Technariumas/dmx-dimmer/sch/dimmer/dimmer.sch.png

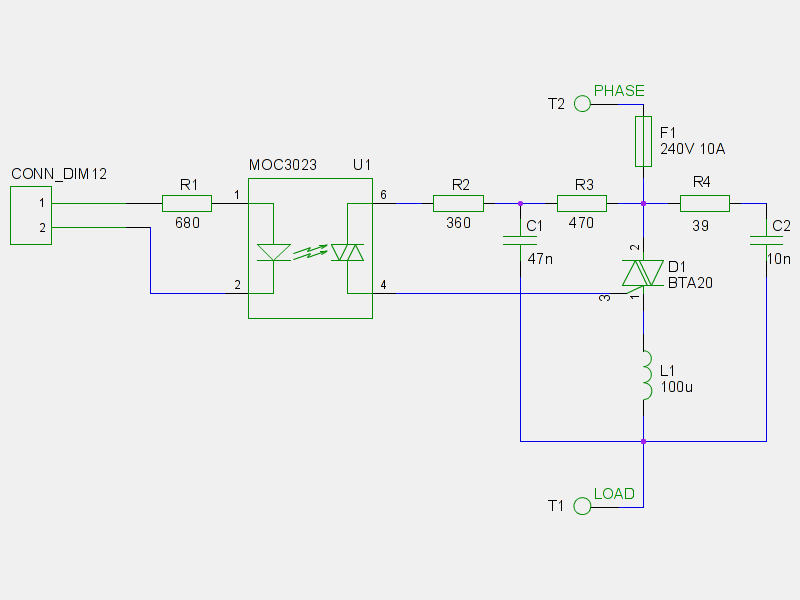
sch/dimmer/dimmer.sch.png
