Technariumas/dmx-dimmer/sch/master/master.sch.png

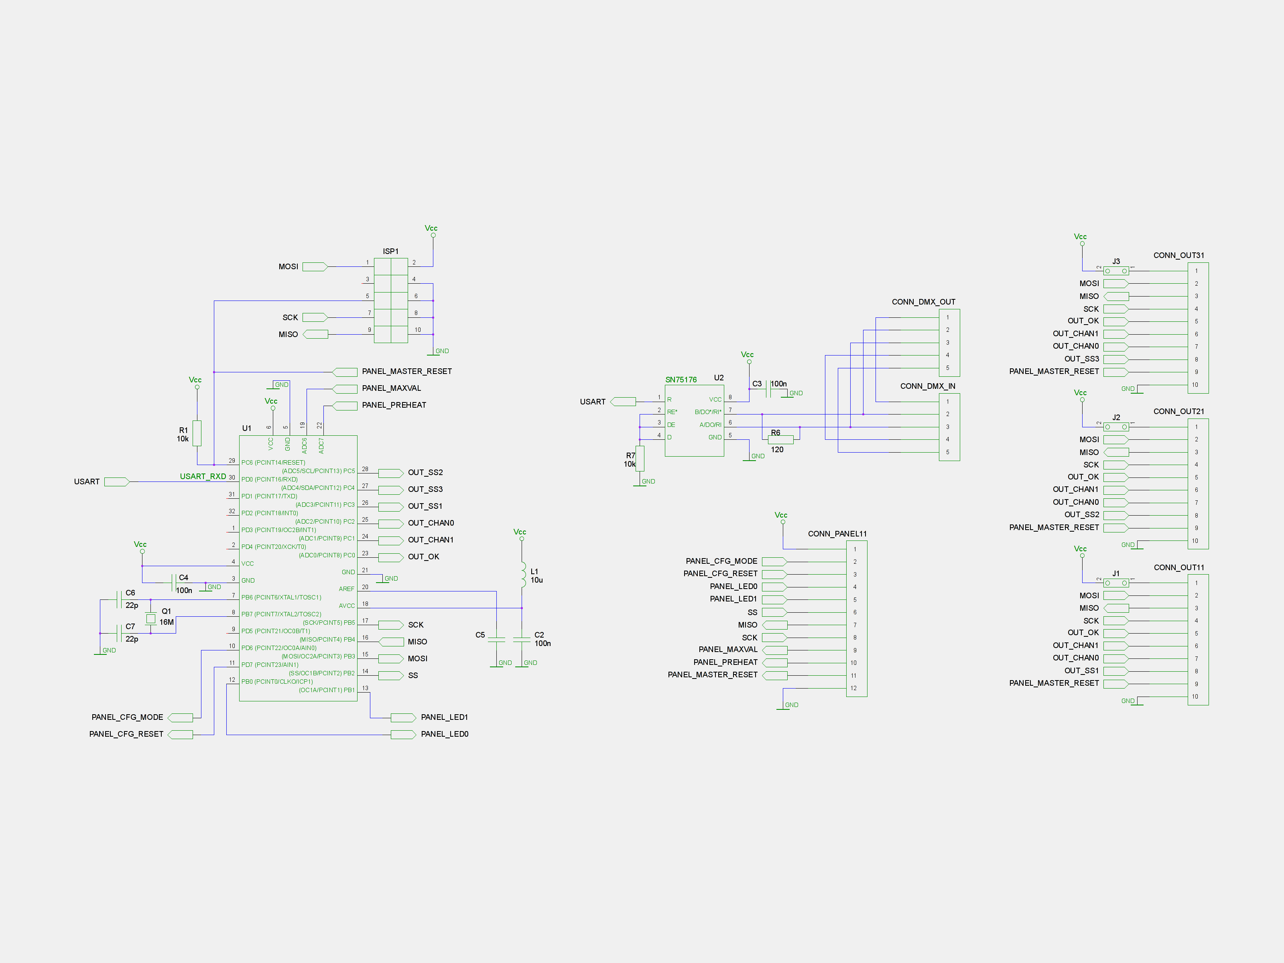
sch/master/master.sch.png
