Technariumas/dmx-dimmer/sch/panel/panel.sch.png

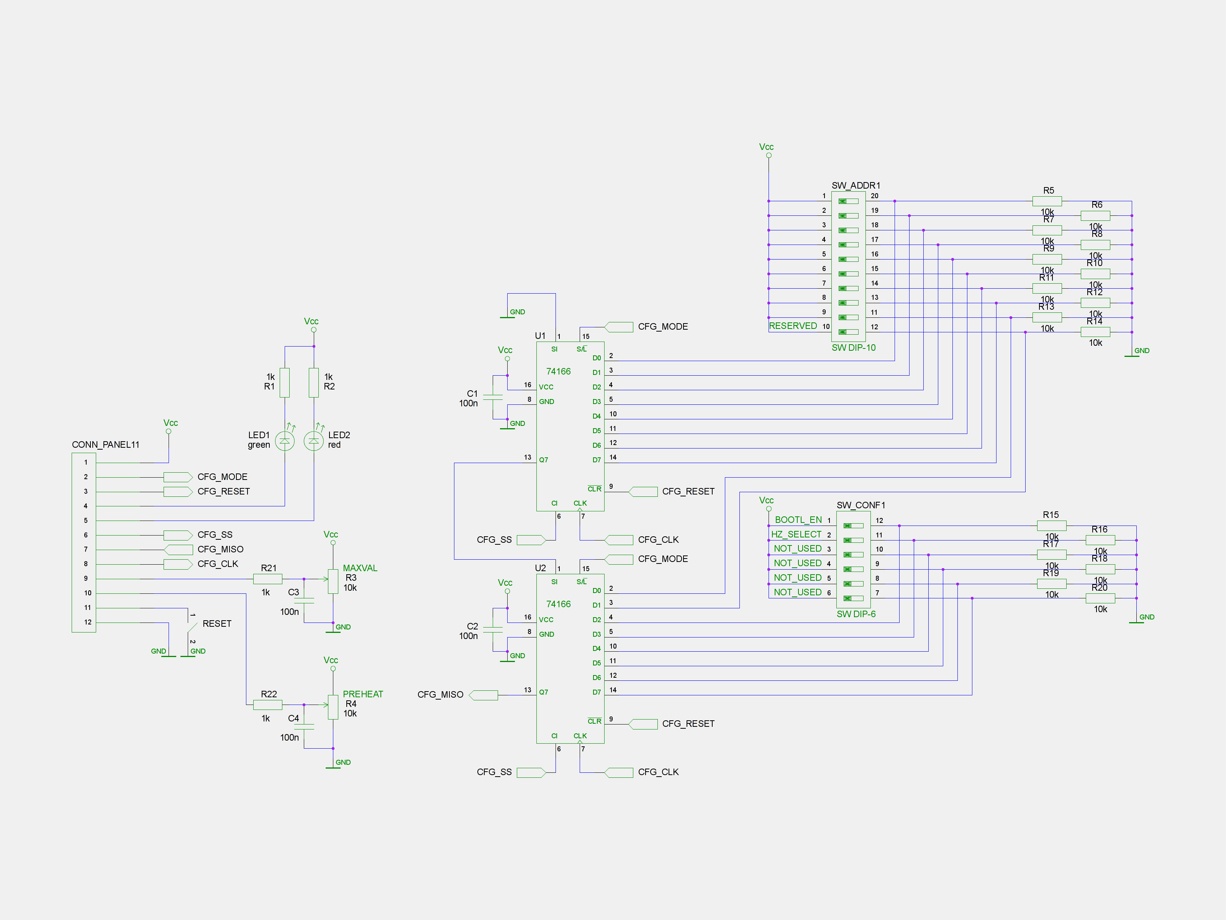
sch/panel/panel.sch.png
