Technariumas/dmx-dimmer/sch/slave/slave.sch.png

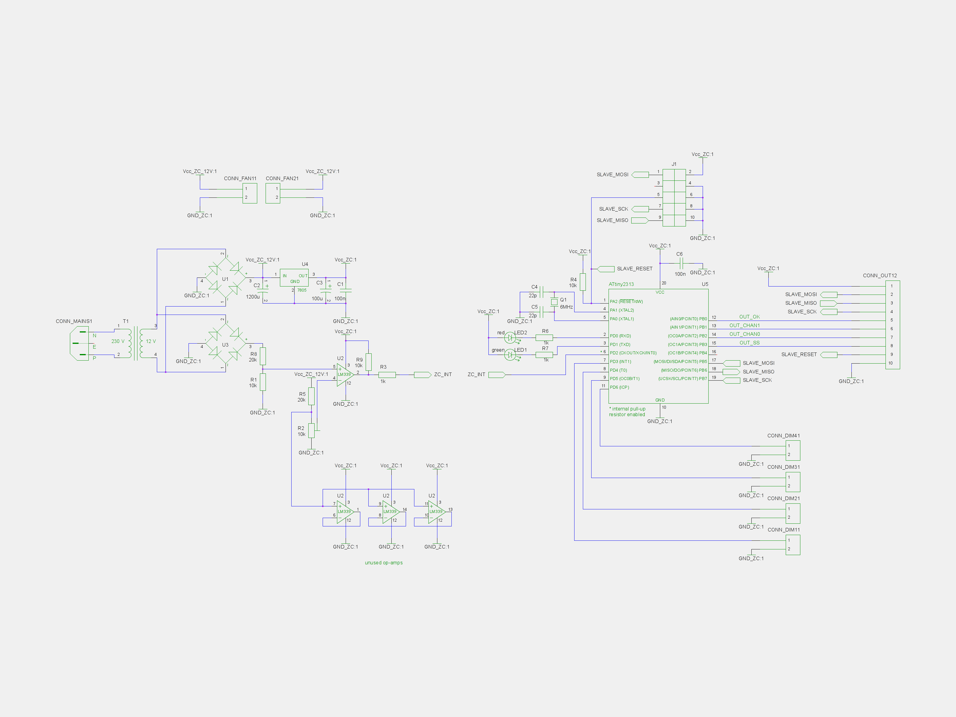
sch/slave/slave.sch.png
