Technariumas/dmx-dimmer/(threads)

Thread 2 (2015-06-25):

Replace wire connectors

rxdtxd, 2015-06-25:
Don't remember model names, but they suck: poor mechanical performance, take long to manufacture. Replace with something better, but keep in mind (as per README) that it has to be "commonly available".
