Technariumas/dmx-dimmer/(list of files, drawings)

Other design files:
sch/dimmer/dimmer.pcb
sch/master/master.pcb
sch/panel/panel.pcb
sch/slave/slave.pcb
