Technariumas/dmx-dimmer/src/slave/spi.c

// spi.c

#include "spi.h"

#include <avr/io.h>
#include <avr/interrupt.h>

#include "slave.h"
#include "iocontrol.h"

inline void spi_slave_init (void) {
    // slave select, dmx channel select, ready to transmit (ok) line
    set_input(SPI_OUT_DDR, SPI_OUT_CHAN0_DDR);
    set_input(SPI_OUT_DDR, SPI_OUT_CHAN1_DDR);
    set_input(SPI_OUT_DDR, SPI_OUT_SS_DDR);
    set_output(SPI_OUT_DDR, SPI_OUT_OK_DDR);

    output_low(SPI_OUT_PORT, SPI_OUT_OK);

    // pull-ups on inputs (hi-z doesn't work with 3 slaves)
    input_pullup(SPI_OUT_PORT, SPI_OUT_CHAN0);
    input_pullup(SPI_OUT_PORT, SPI_OUT_CHAN1);
    input_pullup(SPI_OUT_PORT, SPI_OUT_SS);

    // DI and USCK are inputs. DO is an output, but has to be set as Hi-Z
    // input to prevent muliple slaves driving one line.
    set_input(SPI_DDR, SPI_DI_DDR);
    set_input(SPI_DDR, SPI_USCK_DDR);
    set_input(SPI_DDR, SPI_DO_DDR);

    input_pullup(SPI_PORT, SPI_DI);
    input_pullup(SPI_PORT, SPI_USCK);
    input_hiz(SPI_PORT, SPI_DO);

    // three-wire mode (SPI), external clock (SPI mode 0)
    USICR = _BV(USIWM0) | _BV(USICS1) /* | _BV(USICS0) */;
}

char spi_slave_receive (void) {
    USIDR = SPI_TRANSMIT_DUMMY;
    USISR = _BV(USIOIF);  // clear overflow flag (start transmission?)
    while ( !(USISR & _BV(USIOIF)) );  // wait for reception complete
    return USIDR;
}
