Technariumas/dmx-dimmer/(commit log)

2011-02-09 initial commit - dmx transceiver
    re-design of hoelscher's transceiver to use a more common/modern atmega168
    instead of atmega8515 + support of >8 channels by using serial to
    parallel ICs
    [transceiver.sch]
2011-02-09 basic avr peripherals
    crystal, isp, reset
    [transceiver.sch]
2011-02-09 dmx and zero crossing
    [transceiver.sch]
2011-02-09 input power, minor separation of functional blocks
    [transceiver.sch]
2011-02-10 last day forgot to save
    [transceiver.sch]
2011-02-10 indicator leds
    red stays on pd7
    green moved from pe0 to pd6
    [transceiver.sch]
2011-02-10 fan control
    moved from pb3 (occupied by isp) to pd5
    [transceiver.sch]
2011-02-10 fan trimpot value
    just s2p connectors left to go
    [transceiver.sch]
2011-02-10 schematic prettify
    [transceiver.sch]
2011-02-11 output to serial-to-parallel shift registers
    [transceiver.sch]
2011-02-11 documentation stub
    [transceiver.sch]
2011-02-11 docs on zc (incomplete), switching mode
2011-02-14 separate schem and src into dirs
    [transceiver.sch]
2011-02-14 code stubs
    usart for dmx (from internets), stubs for other peripherals
    [transceiver.sch]
2011-02-15 yesterday, something
    [transceiver.sch]
2011-02-15 dipswitch selector for number of channels, some buggy code
    [transceiver.sch]
2011-02-15 prettify schematic
    [transceiver.sch]
2011-02-17 board remake - no channel number selector, dimmer address setter instead
    to get enough pins, replace isp (4 pins) with usb (2 pins), remove
    thermo control
    TODO: figure out how to reset
    [transceiver.sch]
2011-02-17 revised schematic
    address selectable, program through usb, ic power source selector
    for programming (use slider ON-ON switch), 50/60 hz selector,
    bootloader enable selector
    dimmer operator controls separated from main schematic, this
    should make it easier to mount the controls on the back pane
    TODO: how to do a reset?
    [transceiver.sch]
2011-02-18 new hardware wants new software
    [transceiver.sch]
2011-02-21 major rework init
    schematic/src: get dmx start address using a parallel to serial
    converter (74LS166)
    [transceiver.sch]
2011-02-21 more spi on schematic
    [transceiver.sch]
2011-02-24 schematic: two 74xx166 parallel->serial to read dmx address and configuration
    [transceiver.sch]
2011-02-24 schematic: serial->parallel (output to lamps), modular
    [transceiver.sch]
2011-02-24 schem: usb and reset
    usb: D+ on PD3 (int1), D- on PD4
    reset: tow pins to connect button
    [transceiver.sch]
2011-03-16 schematic: fix bad gschem symbols
    [transceiver.sch]
2011-03-22 schem: better usage of shift/storage register clock lines
    Now SPI_CLK connects to (595's) internal shift register clock
    line, and data on SPI_MOSI is always shifted into this register.
    However, the contents are only transmitted to storage register and
    external output on positive edge of SPI_SLAVE2 slave selection line.
    This is NOT the general /SS of SPI, which is actually not used.
    SPI_SLAVE2 is currently on pin PC1 of atmega168.
    Previous setup of common clock for both registers didn't seem to
    work on breadboard. Parallel outputs would show intermediary
    stages of internal shift register, while the data was still being
    shifted through the serial input.
    [transceiver.sch]
2011-04-05 schematic: working and breadboard-tested serial-to-parallel and parallel-to-serial converters
    pts uses 166 (may be substituted with 165 if schematic modified for
    different pinout), stp uses 595
    other schematic layout changes:
    + more visible "panel" part
    + power through usb removed
    TODO:
    - zero crossing
    - proper power supply (mains to brains and triacs)
    - lamp "exciters" (triacs and stuff)
    [transceiver.sch]
2011-04-06 schem: zc added
    [transceiver.sch]
2011-04-06 schem: added power dimming module; refined serial-to-parallel and usb modules
    Power dimming using optoisolator (circuit protection) and triac
    (switching). Based on Hoelscher's version and ON Semiconductor's
    application note AND8011/D ("High Resolution Digital Dimmer").
    Not yet tested. Differs from Hoelscher's design, since optoisolator
    is controlled by STP converter 595, not directly by microcontroller.
    595 assumed to be capable of sourcing at least 4 mA for each output pin
    (32 mA total). MOC3022 optoisolator specifies 1.5 V drop on internal
    diode (but at 10 mA forward current). Thus resistor between 74HC595 and
    MOC3022 changed from 390 ohms to 820 ohms. Also, 595 output is used
    active high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
    [transceiver.sch]
2011-04-07 use sources of project 'spi' instead of old sources
    'spi' is known to work. It is probably easier to build on that rather
    than integrate new working code into the old version (now in directory
    'src-babel').
    NOTE TO SELF: in the future, ALWAYS test new code ASAP. You can write a
    lot of really smart stuff, but if it's not tested, it'll topple over
    like the Tower of Babel. Trying to make frameworks that components
    "can be plugged into later" is wishful thinking. You'll spend more time
    integrating incompatible code and rewriting definitions than you would
    have building from the ground up.
    At least until there are abstract enough libraries.
    [transceiver.sch]
2011-04-07 firmware: dirty but working zc, minor spi fixes
    Zero crossing interrupt increments a counter and outs the value. CZ
    circuit verified, works OK.
    Seems that SPI still had OBOEs, reversing SPI clock polarity back to
    normal seems to fix it.
    Yeah, yeah, two separate things in one commit, I know.
2011-04-08 basic out to lamp
    [transceiver.sch]
2011-04-11 code: experimental counter usage to determine second zero crossing
    NOTE: Current zero crossing schematic only allows detecting one AC
    half-cycle. Depending on where the current-limiting resistor on the
    output of the optocouple is placed, you can have a defined rising or
    falling edge, but not both. When the transistor is non-conducting, it
    seems to act as a capacitor.
    This introduces the need to use a counter to detect every
    other zero crossing. It is annoying and it complicates the code.
    A better ZC detector is required, where both rising and falling edge
    are usable.
    On the other side, a counter is needed anyway to determine the firing
    angle. At 16Mhz CPU clock and 50 Hz mains frequency (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
2011-04-13 schem: initial rework of zc/dimming modules
    Using the microcontroller to detect ZC seems to be a dead end. With three
    phase power supply, zero crossings on different phases appear at different
    times. This would require three times more data transmissions to dimmer
    module optocouples.
    A different approach using per-phase ZC detectors seems feasible. It
    requires certain design considerations to be made. Most of these are
    lifted from ON Semiconductor's application note AND8011/D, titled
    "High Resolution Digital Dimmer".
    ZC detection is achieved using op-amps (comparators). At this moment it
    is not clear if every dimming channel would require a separate op-amp,
    or if one per phase can be utili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
    [transceiver.sch]
2011-04-15 schem: finished zc/dimming module, added digipot symbol, but see details
    Using a digipot seems to be impossible now. Added complexity aside, they
    have a limit on maximum current in the range from 0.5 mA to 20 mA (and
    the latter are expensive). Charging the 555 cap requires currents of
    VCC/100 (maximum value, when pot resistance is 0). Even for 5 V, this is
    50 mA.
    So scrap this digipot wankery.
    Perhaps a dedicated microcontroller might be up for the task. If it
    chooses its clock crystal wisely, it can detect ZC, receive delay values
    from the Master, and issue pulses when necessary.
    And you better not ask a hobbit to do it.
    [transceiver.sch]
2011-04-18 schem: zc/dimmer module rework
    There are four channels on each mains phase. Every phase's ZC is detected
    by an op-amp (comparator) and sent to a microcontroller (ATtiny2313).
    This uC counts ZCs, divides intervals into 255 angles, and communicates
    with the Master uC to get firing angle values for its four controlled
    channels.
    Used: 8-bit counter, 16-bit counter, external interrupt INT0 (any falling-
    edge-triggered interrupt should be OK), SPI (TWI aka I2C should have been
    OK, too), 4 I/O pins for DMX channel, 2 I/O pins for slave address setting,
    4 I/O pins for optocouple firing.
    Two pins left unused - connect LEDs?
    Outstanding:
    - Is it OK for an op-amp to operate at 5V, but compare 12V?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
    [transceiver.sch]
2011-04-21 code:dimmer: nah, remove all previous code, add debug led code
    All previous code is still in transceiver/main.c.
2011-04-21 schem: zc tested, works ok
    There has to be a pull-up after the op-amp, perhaps ATtiny2313's internal
    can be used. But [1].
    Also, schematic has a 100 uF cap before L7805, that gives visible ripple
    on op-amp's non-inverting input. 1200 uF helps a lot.
    [1] Is a current-limiting resistor after the op-amp needed? If so, can
    uC's internal pull-up still be used?
    [2] Which cap to use before L7805?
    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
    [transceiver.sch]
2011-04-26 attiny2313 counts zero crossings
    code:
    zc_init() enables ZC interrupt and is essentially complete.
    ISR(INT0_vect) is a stub. Should determine how many cycles pass
    between two ZCs and divide this interval into [0 255] firing angles.
    timer1_init() enables cycle counting. This count will be used by
    ISR(INT0_vect).
    ISR (TIMER1_COMPA_vect) is just testing. Timer resetting should be performed by ISR(INT0_vect). Should be replaced by TIMER1_OVF1_vect, which happens on counter overflow, which means no zero crossing was detected in a long time and mains frequency is too low.
    Not Yet Implemented:
    Timer0, which gets a duration between two firing angles (from ISR(INT0_vect)) and fires dimmer chann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
    [transceiver.sch]
2011-04-26 schem: cap before 7805 changed to 1200uF
    code: no changes, accidentally touched main.c
    [transceiver.sch]
2011-04-26 code: zc interrupt calculates degree duration, stores in TCNT0
2011-04-26 code: zc interrupt done, reads/resets counter1, sets counter0
    ISR(INT0_vect) resets Timer/Counter1, calculates average between current
    and previous durations between zero crossings, and sets firing angle
    degree duration in Timer/Counter0.
    zc_init() and counter1_init modified and cleared up accordingly.
    Compare match interrupt replaced with overflow interrupt stub.
2011-04-26 code: half-working dimmer channel firing
    Turns out Timer/Counter0 of ATtiny2313 doesn't have Output Compare, so
    Timer/Counter1's is used instead. This presents some difficulty, since
    you can't reset the counter when you want to. Increasing the OCA seems
    to be feasible (i.e. desn't take too many CPU cycles).
    Still, the counter somehow overflows, even though it is reset on every
    ZC (ORLY?). Investigate.
    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
2011-05-02 code: zc works!
    ...just a little regulation left - tested only on the highest trimpot
    setting.
    Timer/Counter0 does have output compare units. Even if it didn't,
    counting from 155 to 255 is no different than from 0 to 100.
2011-05-03 schem: minor adjustments to zc and dimmer uC
    Schematic now corresponds to what's on the devboard. More or less.
    [transceiver.sch]
2011-05-03 schem: rewire for simpler uC-uC communication
    Make it possible to just write the DMX channel address to the lower nibble
    of a port. That's PORTB for ATtiny2313, PORTC for ATmega168.
    [transceiver.sch]
2011-05-03 schem: prettier wire layout to panel
    [transceiver.sch]
2011-05-04 uCs talk to each other
    Both schematic and code changes to implement this.
    Master has three slave select lines. They are connected to Slaves' PCINT
    pins, which means interrupts are detected on pin toggle. Since slaves
    have a lot more stuff to do than the Master, they get to that interrupt
    when they can, prepare their hardware and signal it's OK to send data.
    When the exchange is complete, they disengage the OK line. (Perhaps this
    should happen sooner - in case Master wants to send a lot of stuff.)
    There seems to be an issue somewhere between ZC detection and angle
    firing - mostly visible when DMX firing angle value is small. The light
    flashes brightly instead of glowing continuously. Maybe: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
    [transceiver.sch]
2011-05-05 code: working zc/dimming, no flicker
    Seems that dimmer module's ZC interrupt was sometimes called in the
    middle of angle interrupt (INT0 and Timer/Counter0 Output Compare A,
    respectively). This caused the control light to turn on for the next 10
    ms, even if it didn't have to.
    TIMER0_COMPA_vect now has ISR_BLOCK. It is a pretty short interrupt, so
    shouldn't interfere with INT0_vect.
    ZC duration calibration is extremely simplified, also for debugging
    purposes.
    The dirty changes in transceiver module are for debugging: they make the
    dmx_value rise and fall gradually over a period of approx. 25,5 seconds.
    Breadboard-wise, the 47nF cap of the dimmer module has been removed to
    seemingly no det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
2011-05-12 code: untested usart (dmx) comm
    Some initial code to communicate with the lighting console through DMX.
    Unable to test it for now: the Enttec USB DMX Pro seems non-responsive:
    permission/driver/console software (QLC) trouble.
2011-05-13 code: more non-working on DMX-USART
    With a pull-up resistor (and current-limiting resistor) on line R from
    SN75176 it seems that data is received OK. But the handling ISR is called
    too often, perhaps it reads everything, not just DMX frames. The Frame
    Error flag is set very often (checked using separate USART test program).
    Data Overruns do not happen, though.
    Perhaps polarity or pins have to be reversed somewhere, or some pull-ups
    added, or the USART chip replaced with a different model.
2011-05-16 schem: minor adjustments to dmx interface
    The DMX line is differential, so don't tie DMX ground to Transceiver
    ground. Avoids potential ground loops by not having two paths to ground
    and, hopefully, reduces noise.
    Also, add pull-up and current-limiting resistors on 75176 R line.
    [transceiver.sch]
2011-05-16 code: working dmx->transceiver
    It's alive! It's alive!..
    USART Receive Complete interrupt rework: implemented a 'case' state
    machine instead of wacky 'if-then-else' test tree.
    Checked using Windows XP computer with Enttec DMX USB Pro diagnostics
    program. Receives 12 channels properly.
2011-05-18 code: re-factoring, code broken into units
    Should have been done long ago. Shouldn't have been committed
    all at once. Some minor changes might have introduced breakage.
    That's OK.
    [fakedelay.c, fakedelay.h, iocontrol.h, spi.c, spi.h, transceiver.c, usart.c]
2011-05-23 code: send all channels to proper arbiters + more refactoring (untested)
    Determine whether received DMX data is new and should be sent to Slaves.
    If so, determine which Slave it should go to.
    Flag data as old (sent) only if SPI data read from Slave is correct.
    [spi.c, spi.h, transceiver.c]
2011-05-24 schem: improve master-slave bus
    - Use standard 8-pin 8-wire connection.
    - Remove exclusive Master power module, use one of Slaves' instead. Which
    one exactly is set using jumpers J1-J3 on Master's board. Only one of them
    should be shortened.
    - Swap OUT_SS and OUT_OK lines for cleaner PCB layout.
    code: reflect latter change in dimmer (Slave's) code.
    [transceiver.sch]
2011-05-24 schem: give unused pin a connector
    3-pin - VCC, SIG, GND.
    [transceiver.sch]
2011-05-24 schem: decoupling capacitors for ICs
    [transceiver.sch]
2011-05-24 schem: transformer primary changed from 110/220V to 230V
    [transceiver.sch]
2011-05-24 schem: add resistor by op-amp's trimpot for finer comparation control
    Without it, op-amp's inverting input can see 0-12 V, but with a VCC of
    5 V. This means only 5/12 of the trimpot are theoretically usable (and
    even less in pactice, it seems).
    With this resistor, inverting input can see 0-6 V coming from the voltage
    divider, giving slightly finer control. The resistor could have a larger
    nominal value, since ZC detection really requires the op-amp's inverting
    input to see something just slightly above 0. Perhaps a 100 k resistor
    should be used instead.
    [transceiver.sch]
2011-05-24 schem: put proper resistor for optocoupler in dimmer schematic
    MOC3023 needs at least 5 mA to latch output reliably. With a maximum
    possible forward voltage drop of 1.5 V, the required resistor is <=
    700 Ohms (at most).
    MOC3023 - 5 mA - <= 700 Ohms
    MOC3022 - 10 mA - <= 350 Ohms
    MOC3021 - 15 mA - <= 233 Ohms
    MOC3020 - 30 mA - <= 116 Ohms
    [transceiver.sch]
2011-05-24 schem: include MISO line from Slave to Master
    ...so use standard 10-pin connector instead of 8-pin. Rearrange line
    layout accordingly.
    code: in dimmer module, change pin defines accordingly. That code still
    has some major TODOs and is not refactored.
    The Master (transceiver) module code is rafactored and still used somewhat
    with the devboard, so leave current pinout for now.
    [transceiver.sch]
2011-06-06 schem: better schematic layout, still a lot to do
    [transceiver.sch]
2011-06-07 code:dimmer: combing
    LEDs and dimmer-control signal lines (to optocouples) now have pretty
    defines.
    main() cleaned up.
2011-06-07 schem: fix and prettify
    CFG_RESET and CFG_MODE were present in two places, which would produce a
    valid and buggy PCB layout.
    Placed two leds at Slave's disposition.
    TODO: communication from Master to 75176 - decide if a TXD line is needed,
    whether to connect /RE, and connect Universe 1 for proper repeating.
    [transceiver.sch]
2011-06-09 schem: rename schematic
    Just about to start making hardware modules, laying out PCBs is easier
    when they're separate.
    [everything.sch]
2011-06-09 code:dimmer: more o' proper multi-channel operation
    Turn off all 4 outputs (to optocouples) in ZC interrupt. Do this without
    costly cycle iteration, so add some more defines.
    Fire one of four channels (not just the first) when new firing angle
    reached.
2011-06-09 code:dimmer: fire channels with value '255' straight from ZC interrupt
    Moved channel value checking/firing code to a separate (inline) function,
    since it's used in two different interrupts.
2011-06-10 schem: separate schematic for dimmer of one channel
    [dimmer.sch]
2011-06-10 schem: gnetlist uref deprecated, use refdes
    [dimmer.sch, everything.sch]
2011-06-10 schem: partial dimmer netlisting, change triac to BTA20
    [dimmer.sch, everything.sch]
2011-06-13 schem: proper DMX retransmitter; don't connect TXD and ~RE (always a receiver)
    [everything.sch]
2011-06-13 code:trans: don't use ~RE (always a receiver)
    TXD pin is also unused, so this leaves two pins. Handy to fit in preheat
    control. Some pin rearrangement is due, though.
2011-06-13 schem: many changes, see full description
    - Proper DMX repeating, connected Universe 1 input receiver to output
    driver.
    - Master connects to USART through 3-pin wire connection. It carries
    VCC, RXD and GND. USART TXD and ~RE are not used.
    - Instead, OUT_SS2 and OUT_SS3 (Slave Select interrupt lines) are connected
    where USART TXD and ~RE were.
    - PREHEAT and MAXVAL are connected to PC4 and PC5 of Master, where OUT_SS2
    and OUT_SS3 were. These are used by Analog-Digital Converter and determine
    the appropriate DMX values. They are connected to two potentiometers on
    the front panel.
    The ATmega168 datasheet states PC0-PC3 are connected to "analog VCC",
    which is probably AVCC, and PC4-PC5 to "di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
    [everything.sch]
2011-06-13 schem: add ISP connectors (with RESET jumpers)
    [everything.sch]
2011-06-14 code:trans: add basic code to read preheat/maxval from pots using adc
    Kinda finished reading ADC values in.
    TODO: determine where to use them: when receiving DMX values on USART
    or when sending to Slaves.
2011-06-15 code:trans: use temp var when relaying chanvals to Slaves
2011-06-16 schem: dimmer with footprints and fresh pcb
    [dimmer.pcb, dimmer.sch, everything.sch]
2011-06-16 schem: finished dimmer pcb layout
    [dimmer.pcb, dimmer.sch]
2011-06-17 schem:dimmer: better layour with proper footprints
    TODO: footprints are still external; include somewhere around
    release.
    [dimmer.pcb]
2012-01-12 schem: don't buffer dmx512, pass thru directly
    Thought putting a retransmitter for DMX512 data was a good idea.
    However, this is not so in real life. If several dimmers are chained
    in a rack and not all of them are used, some dimmers may be turned off
    (to use less power). In such case, the buffer's SN75176 will prevent
    the signal from passing on, since they have no power.
    So this now only has one SN75176, the one proper to translate
    differential signals to simple USART, to be passed on to the master
    uC.
    pcb: some leftovers from last commit, which happened half a year ago.
    [dimmer.pcb, everything.sch]
2012-01-12 schem: re-arrange functional blocks + a few minor fixes
    Put them blocks around so that a frame can be put in later.
    Move led resistors to panel, they have nothing to do by the Master.
    Allows using those two pins for something else if LEDs are not
    wanted.
    [everything.sch]
2012-01-12 schem: move ISP header for more pretties
    [everything.sch]
2012-01-12 schem: change ATMega168 package from DIP28 to TQFP32 code: minor changes to ADC handling
    DIP28 was used with a protoboard. On a prototype board TQFP32 is
    to be used (better local availability, smaller footprint).
    The latter has four more pins: VCC, GND and two more ADC channels,
    ADC6 and ADC7. These can be used for ADC only, and since we're using
    two ADC channels for maximum value and preheat settings, it is better
    to leave GPIOs PC4 and PC5 unused.
    Note that the code currently is incomplete, it doesn't read these
    two settings or switch between ADC channels.
    [everything.sch]
2012-01-13 schem: minor layout fixes
    [everything.sch]
2012-01-13 schem: copy Master to separate schematic, prepare to lay out PCB
    [everything.sch, master.sch]
2012-01-13 schem: ran master.sch through grenum
    [master.sch]
2012-01-13 schem: more grenum, some footprints added
    [master.sch]
2012-01-13 schem: more footprints for Master schematic
    [master.sch]
2012-01-13 schem: for now, place SN75176 on same schematic as Master uC
    [master.sch]
2012-01-13 schem: use 'terminal' device and appropriate footprint for 3 unused pins
    [master.sch]
2012-01-13 schem: all footprints written for Master pcb
    [master.sch]
2012-01-13 schem: netlist fixes and link to minimelf package
    gEDA has a specific way of making netlist connections. If two nets are connected by input/output module ports (and there's a lot of these for cleaner layout), the 'net' attributes on these ports have a default (inherited) value (INPUT:1 and OUTPUT:1). Maybe these were only meant to connect separate .sch files, I don't know.
    Anyway, 'net' attributes for these ports should look like NET:NUMBER.
    Also, the MiniMELF footprint (3.6 V zeners are only available in this one locally) is not present in gEDA's default library, so a symbolic link was temporarily added to ~/.pcb/footprints.
    TODO: include all custom symbols and footprints in this project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
    [master.sch]
2012-01-13 pcb: add Master PCB with placed components
    No routing done yet. Might need layer play.
    [master.pcb]
2012-01-13 pcb: move through-hole components to 'component' side
    [master.pcb]
2012-01-14 pcb: everything except one connection laid out, lousily
    This will have to be remade, with a better footprint for the layout
    connection, better pinouts from the microcontroller, fatter traces and
    so on.
    Too many jumpers and wires. If everything else fails, consider a
    two-sided board.
    [master.pcb]
2012-01-14 schem: remove USB from Master schematic
    After some consideration I decided to remove everything USB. Having a
    bootloader was useful during initial prototyping, but it's two more pins
    on the Master, a lot of traces to the panel connector, and a feature
    that's not strictly necessary on a DMX dimmer.
    [master.sch]
2012-01-14 schem: reorder pins on connectors
    To, hopefully, allow using less jumpers.
    [master.sch]
2012-01-14 schem: regenerate empty PCB, track old one for reference
    Trying to lay out a cleaner PCB, with less jumpers and all.
    [master-wacky.pcb, master.pcb, master.sch]
2012-01-14 schem: testing pcb layout, nice so far, except for the ISP header
    Five jumpers, might be a few more when real trace widths are set.
    [master.pcb, master.sch]
2012-01-14 schem: Master pcb test layout done, total of 8 jumpers
    Slave selection pins have to be rearranged, otherwise 9 jumpers will be
    required.
    Components may be tightened after that.
    [master.pcb]
2012-01-14 schem: minor
    [master.pcb]
2012-01-14 schem: finish test schematic/netlist/layout
    [master.pcb, master.sch]
2012-01-14 schem: only one universe of DMX is used, so use appropriate connector
    Previously, CONN_DMX_IN was an 'CONNECTOR 5 1' m4 footprint. Now use
    'CONNECTOR 3 1'.
    [master.pcb, master.sch]
2012-01-16 pcb: master layout, tighten components (partial)
    [master.pcb]
2012-01-16 pcb: more master tightening (second partial)
    [master.pcb]
2012-01-16 schem: remove ISP_ENABLE jumper
    Can't remember why it's there, probably some ancient leftover.
    [master.pcb, master.sch]
2012-01-16 pcb: master PCB done
    Also, ground plane added. Board size left as-is.
    [master.pcb]
2012-01-23 master pcb: smaller drill sizes (for homebrew manufacture)
    [master.pcb]
2012-01-23 naster pcb: mirror legend
    [master.pcb]
2012-01-23 master pcb: resize board space, add outline
    [master.pcb]
2012-01-23 master pcb: nah, remove outline and shrink board size even more
    'pcb' seems to export the outline layer together with component layer.
    [master.pcb]
2012-01-23 master pcb: doh, revert, outline needed after all
    Hard to cut it out with scissors otherwise
    [master.pcb]
2012-01-23 master pcb: fatten copper traces
    [master.pcb]
2012-01-26 remove initial prototype design from tree
    Can't even remember what was bad about it.
2012-01-26 rename "schem" to "sch"
    Don't really know why, but three-letter shorthands are cool like 8.3.
    [dimmer.pcb, dimmer.sch, everything.sch, master.pcb, master.sch]
2012-01-26 src/master: remove all references to debug leds used on metaboard
2012-01-26 src/master: modify code for new pcb layout
    BTW, it looks awful.
2012-01-26 src/master: don't init ADC for now, while panel module is unavailable
    Perhaps MAXVAL/PREHEAT can be removed altogether. Modern lighing consoles
    have this in software. Older consoles, though, or purely software-based
    solutions like qlc most probably won't.
    [master.c]
2012-01-26 sch/slave: move to separate file
    This should all be merged to one directory, as gschem tutorials
    suggest. Later.
    [slave.sch]
2012-01-26 sch/slave: fix schematic for new master<->slave pinout
    Also, remove separate header CONN_CUSTOM for unused pin.
    [slave.sch]
2012-01-26 sch/slave: remove ISP_ENABLE jumper
    [slave.sch]
2012-01-26 sch/slave: minor tyding up
    [slave.sch]
2012-01-26 sch/slave: minor clean-up
    [slave.sch]
2012-01-26 sch/slave: fix nets of connectors
    [slave.sch]
2012-01-26 sch/slave: footprint attribs added to slave.sch
    Some from gedasymbols.org, will link packages folder
    [slave.sch]
2012-01-26 sch/slave: change crystal footprint to HC49smt.fp fro gedasymbols.org
    [slave.sch]
2012-01-28 sch/slave: change diode bridge to footprint DF_S.fp
    Found on gedasymbols.org
    [slave.sch]
2012-01-28 sch/slave: generated .pcb files
    [slave.pcb]
2012-01-28 sch/slave: imported netlist to slave
    All footprints verified to be fine. One element in schematic is
    left without a footprint. That's the mains connector, where power
    comes in from. This will be two screw terminals.
    [slave.pcb]
2012-01-28 sch/slave: pcb components spread out, moved to proper layer
    [slave.pcb]
2012-01-28 sch/slave: power components layed out on pcb
    [slave.pcb]
2012-01-28 sch/slave: pcb laid out, drill/ring sized
    [slave.pcb, slave.sch]
2012-01-28 sch/slave: (almost) all pcb components laid out
    What's left is to connect the power module to the Slave.
    [slave.pcb]
2012-01-28 sch/slave: pcb entirely connected
    [slave.pcb]
2012-01-28 sch/slave: screw-on terminals, info and ground plane added
    [slave.pcb]
2012-01-28 sch/slave: remove ground plane from under power, fatten traces
    [slave.pcb]
2012-01-29 sch/slave: final touches
    [slave.pcb]
2012-01-29 sch/slave: edited name of pcb
    [slave.pcb]
2012-01-29 sch/slave: fatten one trace
    [slave.pcb]
2012-01-29 sch/slave: re-route one trace to allow fattening
    [slave.pcb]
2012-01-29 sch/slave: increase clearance for microcontroller and around
    [slave.pcb]
2012-01-29 sch/slave: more clearance fixing, another ground plane polygon
    [slave.pcb]
2012-01-29 sch/slave: minor fix
    [slave.pcb]
2012-01-29 sch/slave: change drill sizes for easier drilling
    [slave.pcb]
2012-01-29 sch/slave: leave space between outline and ground plane
    Otherwise some unwanted artifacts happen when printing.
    [slave.pcb]
2012-02-05 sch/master: use proper footprint for master-slave connectors
    After assempling the first prototype it turned out the cheap connectors I have are rather big. So resize the board, too.
    [master.pcb, master.sch]
2012-02-05 sch/slave: change footprint of C2 from SMD to through-hole
    After manufacturing a prototype board it turned out it's better to use a through-hole here, since it's a large cap it sticks out too much on the underside. Easier to mount, cheaper, greater component availability.
    [slave.pcb, slave.sch]
2012-02-05 sch/slave: move mains input and mount screw hole further apart
    [slave.pcb]
2012-02-05 sch/slave: board version bump
    [slave.pcb]
2012-02-05 sch/master: board version bump
    [master.pcb]
2012-02-05 update readme with links to custom symbols and footprints
2012-02-07 src/slave: change code to reflect new master-slave connector pinout
2012-02-07 sch/slave: debug leds should be on component side, TH packages
    If you intend to use debugging LEDs, you obviously want to see them.
    [slave.pcb, slave.sch]
2012-02-07 sch/slave: modify drill sizes for simpler drilling
    Especially the vias. I missed two on one prototype PCB, since the pin holes were too small and didn't etch through.
    [slave.pcb]
2012-02-07 sch/slave: minor
    [slave.pcb, slave.sch]
2012-02-07 sch/master: change dmx line resistor from 100 ohms to 120 ohms
    This resistor is optional, I've seen boards where it is omitted, relying on a terminator to be at the end of the line. However, if it is to be included, it should have a proper value.
    [master.sch]
2012-02-07 src/slave: added writefuses option to makefile
    Fuses tested to program OK, the uC can be accessed using terminal mode after that, so these settings seem to be safe. Whether they are correct is another issue, I'm too lazy to look for the microcontroller used when proboarding.
2012-02-10 src/slave: code cleanup
    Tested ZC to work OK. A pull-up resistor is probably needed on the output of the op-amp (LM339). Will add that and ground unused inputs.
2012-02-11 sch/slave: properly terminate unused op-amps (doh!)
    I'll be having some noise and power consumption trouble with my PCBs now, I guess. :(
    Schematic lifted from Maxim AN1957. Perhaps this is different for a single-rail op-amp?
    [slave.sch]
2012-02-11 sch/slave: only one resistor divider pair is needed
    [slave.sch]
2012-02-11 sch/slave: better component positioning
    [slave.sch]
2012-02-11 sch/slave: pull-up resistor added after zc detector (op-amp)
    [slave.sch]
2012-02-11 sch/slave: change led resistors from 680 ohms to 1k ohms
    Slightly lower power consumption, more common value components.
    [slave.sch]
2012-02-11 sch/slave: set 'invisible' attribute on all footprints
    Cleaner schematic.
    [slave.sch]
2012-02-11 sch/slave: propagate latest schematic improvements to pcb
    See previous commits as to what these are.
    The PCB is leaves some things to be desired in terms of tight layout, but at least it should be in better working condition now.
    [slave.pcb]
2012-02-11 sch/slave: instead of having two more resistors, have one and rewire
    Will require component renaming eventually. (sigh)
    [slave.sch]
2012-02-11 sch/slave: propagate changes from schem to pcb
    [slave.pcb]
2012-02-12 src/master: fix old defines and get leds back
    Some bad values for SPI communication lines were still there: using PORTC instead of PORTD now.
    Master sends LED signals to panel, so put those back in.
    Change TRANSCEIVER_H to MASTER_H.
    [master.h]
2012-02-12 scr/master: debugging stuff
    Currently testing Master-Slave SPI communication. Works, but flaky. Slave can't get ZC sometimes if it's connected to Master.
2012-02-12 src: somewhat working version, one channel, range from dmx value 75
    Yeah, I know I should be commiting these things to a different branch. Since no one's using it yet except for me, this is acceptable.
    It is possible to dim a single channel, although the lowest value that has any effect on the output is around 75. Probably a calibration/angle/op-amp comparator issue.
    Also, can't seem to read channel selector value in Slave. The pins used to be different during prototyping.
    Diff from last commit:
    Master:
    - DMX_CHANNELS set to 1.
    - Do check if new data is present, and only send if so.
    - Debug LED for SPI transmission: turn on and off instead of flashing.
    Slave:
    - Don't use dimmer_* macros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
    [dmx.h, master.c, slave.c, slave.h, zc.c]
2012-02-18 src/slave: enable pull-up for interrupt pin to improve noise immunity
    PCINT3 is triggered on both edges, and Master simply toggles it when new data is available. The level on this pin stays in the previous state otherwise. When slave was unconnected to Master, it would get sporadic interrupts, probably due to noise. So enable a pull-up for this pin.
    [slave.h, spi.c]
2012-02-18 src/slave: make comments in zero crossing interrupt more readable
2012-02-18 src/slave: move time-critical counter reset forward
    Firing angle duration counter/timer 0 keeps counting while we're off firing channels. Since routines to do the latter were changed some time ago to do debugging, this caused a considerable delay. The smallest value to fire was 72. Now it's 42, which is quite good, but means something else is still delaying.
    [slave.c]
2012-02-18 src/slave: optimise channel firing routine for speed
    Right now hard-coded for 4 channels. Also, doesn't seem to help. The lowest chanval that fires is around 40.
    [slave.c]
2012-02-20 src/slave: fix issue with delayed angle firing and a plethora of other minor fixes
    This was due to the angle counter being reset in-software as the first instruction of the interrupt routine, instead of in-hardware at the exact moment of interrupt. It takes 40-50 CPU cycles to start a blocking interrupt routine (stack pushing, interrupt disabling, etc.).
    This commit includes a lot of other things that were added/changed while debugging. It's too cumbersome to separate them into separate commits. Once again, a reason to use a separate branch for debugging.
    Most importantly, dimmer_on, dimmer_off and dimmer_init defines are used once again (there was nothing wrong with them). Perhaps they wi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
    [slave.c, zc.c, zc.h]
2012-02-21 src/slave: remove leftover debug code (fixed)
    [slave.c]
2012-02-21 src/slave: fix iocontrol definitions and set CHAN selectors as inputs
    There was some confusion in iocontrol.h. It's been a while since I used inputs!
    Also, seems CHAN0 and CHAN1 were not initialised as inputs properly, left in tri-state. Forgot to do it when switching from breadboarding to proper prototyping.
    [iocontrol.h, spi.c]
2012-02-21 src/master: fix iocontrol definitions (copy from slave)
    TODO: Since this file is common for both parts (Master and Slave), it should probably be kept in just one copy.
    [iocontrol.h]
2012-02-21 src/master: had wrong pinout for chan selector
    Looked at the schematic closely, turns out it's inverted, too.
    [master.h]
2012-02-21 src: working multi-channel operation, dirty code
    Removed fancy code, which is also hard to read and debug.
    The version in this commit has all four channels working. However, there seem to be some stability issues.
    First, the slave enters the "new data from Master" interrupt spontaneously on start-up. Or so it seems, since the green debug led comes on.
    Second, there is noticeable flicker in dimmed lamp output. The reason for this also unknown. Perhaps it's my test setup. The dimmer module, soldered on protoboard, doesn't have a choke.
    [dmx.h, master.c, slave.c, spi.c]
2012-02-21 minor
    Also, the flickering mentioned in previous commit is not preent if the scope's ground probe is attached to schematic ground. Seems to be a noise issue.
2012-03-10 sch/panel: copied from 'everything.sh' and updated
    [panel.sch]
2012-03-10 sch/panel: minor additions
    [panel.sch]
2012-03-10 sch/panel: tighten schematic
    [panel.sch]
2012-03-11 sch/panel: fixed missing pinlabel, set all footprints
    Ready for PCB generation.
    [panel.sch]
2012-03-11 sch/pcb: first version of pcb, unplaced, unrouted
    [panel.pcb]
2012-03-11 sch/panel: changed dipwitch symbols to better ones
    Also solves bad pinout issue.
    [panel.sch]
2012-03-11 sch/panel: better refdes for dip switches
    [panel.sch]
2012-03-11 sch/panel: proper footprint for configuration dipswitch
    [panel.sch]
2012-03-11 sch/panel: pcb with proper footprints
    [panel.pcb]
2012-03-11 sch/panel: too drunk
    [panel.sch]
2012-03-11 sch/panel: too drunk to continue
    [panel.pcb]
2012-03-11 sch/panel: more optimisation, removed one jumper
    [panel.pcb]
2012-03-12 sch/panel: add decoupling caps to analog pots
    [panel.sch]
2012-03-12 sch/panel: propagate decoupling caps to pcb
    [panel.pcb]
2012-03-12 sch/panel: added ground plane on PCB
    [panel.pcb]
2012-03-12 sch/panel: fattened a few traces
    [panel.pcb]
2012-03-12 sch/panel: fattened power line
    [panel.pcb]
2012-03-12 more of the same
    [panel.pcb]
2012-03-12 sch/panel: added current limiting resistors from pots
    [panel.sch]
2012-03-12 sch/panel: propagate current limiting resistors to pcb
    [panel.pcb]
2012-03-12 sch/panel: added link, board name and oshw logo
    [panel.pcb]
2012-03-12 sch/panel: last-minute fixes
    [panel.pcb]
2012-03-12 sch/panel: panel fixes after printing and inspection
    [panel.pcb]
2012-03-13 sch/panel: increase current limit resistor values to 1k
    [panel.sch]
2012-03-14 sch/panel: reserve switch for universe selection
    The logical solution is to use ADDR dip switch pin 10.
    [panel.sch]
2012-03-20 src/master: latest debug led blinking
2012-03-20 src/master: pull up interrupt pins so no fake int occurs
    Used to happen that at power-up, slave would think it got an interrupt. This was because the slave pulls up its interrupt pin, and the master doesn't.
    For now, make both sides pull it up.
    [spi.c]
2012-03-20 src/slave: debug other stuff with leds
2012-03-20 sch/master: fixed physical layout
    Better mounting, bigger spacing.
    [master.pcb, master.sch]
2012-03-20 sch/slave: fix physical
    Spacing around mount screws, better "faux" pinout for mains power connector (allows a more steady mount), other spacings and layout fixed.
    [slave.pcb]
2012-03-20 sch/panel: fix physical layout
    Better spacing for mount screws, Master<->Panel connector moved between screws to allow a 90-deg. angle connector be used on a single-sided board.
    [panel.pcb]
2012-03-20 sch/everything: remove, split into separate modules
    [everything.sch]
2012-03-20 sch/slave: change mains power connector to proper (custom) footprint
    [slave.pcb, slave.sch]
2012-03-20 sch/dimmer: modified schematic for improved layout
    Changed footprints of triac and terminals.
    [dimmer.sch]
2012-03-20 sch/dimmer: entirely new layout, from scratch
    Fixes issues with wrong triac pinout, no connectors, bad spacings, wrong drill sizes.
    [dimmer.pcb]
2012-11-09 sch/dimmer: minor 'onsolder' additions, deselection, and probably bugs
    I don't know what's in this commit, really. A leftover from last year.
    [dimmer.pcb]
2012-11-09 src/master: make dmx_t dmx structure volatile to prevent nasty optimisations
    Thanks to @miceuz who used the code for a dmx led dimmer. Had trouble with addressing and optimisations if the structure is not volatile. Addressing is currently not implemented in dmx-dimmer, but let it be so for the future, and lest we forget.
    [master.c]
2012-11-19 sch: make footprints invisible on schematics and export them as png
    For all your happy derivatives. :)
    [dimmer.sch, master.sch, panel.sch]
2012-11-19 doc: add minimal README to schematics
2013-02-15 sch/dimmer: re-route rev2
    [dimmer.pcb, dimmer.sch]
2013-02-17 sch/dimmer: add fuse holder and re-route board
    Not strictly necessary, since I won't be using fuses here in favour of automatic circuit breakers (at least such is the plan), but it's best to put this option in for someone who won't.
    [dimmer.pcb, dimmer.sch]
2013-02-17 sch: rename {schematics}.png to {schematics}.sch.png
    These are PNGs of schematics, PNGs of PCB layouts to follow.
2013-02-17 sch/dimmer: update schematic png
2013-03-19 src/slave: turn on red led upon startup
2013-03-21 src: enable 12 channel operation, still buggy
    Only 1 slave works right now. It is obvious that waiting for a slave OK
    indefinitely is not good. Commit this as a safe point.
    [dmx.h, fakedelay.c, master.c, slave.c, spi.c]
2013-03-25 src: 3 slaves can now be addressed separately (READ LONG DESCRIPTION)
    Slaves' OUT OK lines were "multiplexed" lousily. In fact, they were not
    multiplexed at all, just three output lines hooked up to the same physical
    line. This might have created logic glitches, so we now have three separate
    physical lines, one for each slave. So two more pins ar used on the master.
    These are on port D (pins D3 and D4). The earlier OUT OK line was (and
    still is, for slave 1) on port C pin 0.
    There is a new function slave_is_available() which takes one uint argument
    and returns 0 or 1. For the master, OUT OK lines are connected to inputs
    with pull-ups. So if the slave is disconnected, there is a logic 1 on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
    [master.c, master.h, slave.c, spi.c]
2013-03-25 src/master: fix FIXME (mystery constant without comment)
    [spi.h]
2013-03-25 src/slave: can now address 3 slaves without lock-ups (MISO conflict)
    Issue with master locking up when more than one slave connected was due
    to all slaves trying to constantly drive the MISO line. Now Slaves' Data
    Out (MISO) line is tri-state (Hi-Z) by default, until Master sends an
    interrupt request to that specific Slave.
    This commit appropriately modifies:
    * spi_slave_init() in spi.c
    * ISR (PCINT_vect, ISR_NOBLOCK) in master.c
    [slave.c, spi.c]
2013-03-26 src/master: remove reference to old single OK line in code from spi.h
2013-03-26 sch/master: updated schematic with 3 separate OUT OK lines
    [master.sch]
2013-03-28 src/master: enable and fix reading address/settings from panel
    Uncommented 2-year-old code and fixed small logic glitch that was
    introduced by fiddling with spi_master_transmit().
    Updated pin definitions.
    Improved comments on why some actions are needed.
    [master.c, spi.h]
2013-04-03 src/slave: don't fire channels if firing angle is 0
    If ZC interrupt pulse duration is not set properly (is too long),
    fire_channels() would be executed when zc.angle counter reaches zero.
    [slave.c]
2013-04-04 src/master: fix bugs in ADC code that prevented 3-slave operation
    Don't disable digital inputs on PORTC (they are used by other subsystems).
    Rewrote channel selection definitions.
    Add explanation comments, update some previous comments to be more
    specific.
    ADC is not yet enabled, there seems to be some kind of a glitch. Probably
    ADC could be read once every 'for(12 channels)' iteration, but even just
    once at start-up would be sufficient. However, there are (currently) two
    ADC channels to be read, and only the last one's value can be truly
    received. Perhaps this is due to the way ADC channels are currently
    multiplexed - without stopping the free-running ADC).
    [adc.c, adc.h, master.c]
2014-09-19 src/slave: `volatile` qualifier to volatile variables.
    Make the slave a bit more volatile just because it has to be quite
    volatile while having at least 3 concurrent interrupt handlers ;)
2014-09-19 src/slave: Move DMX data read routine from interrupt to main loop.
    PCINT3 interrupt disabled. Chan value reading deobfuscated.
2014-09-19 src/slave: Use LEDs for debugging hang.
2014-09-19 src/slave: Better LED debugging.
2014-09-20 src/slave: Fix hang in main loop.
    Reset the slave-select flag immediately after it changes.
    [slave.c]
2014-09-20 src/master: Send data to slaves continuously. Name LEDs.
2014-09-20 src: Move LED definitions to headers.
2014-09-20 src/slave: Make interrupts blocking.
2014-09-20 src/master: Enable C99 mode in Makefile, make functions inline properly.
    Inline function definitions had to be moved from spi.c to spi.h,
    otherwise they aren't inlined (across translation unit boundaries).
2014-09-20 src: Simplify slave selection.
    Instead of toggling slave-select pins, output 1 until slave answers and
    then reset back to zero before beginning actual data transmission. This
    way the slave doesn't have to track any state and can just wait for a 1.
    [master.c, slave.c, spi.h]
